naibaf7/OpenDynKVM/hardware/bom/jlcpcb_bom.csv

Comment | Designator | Footprint | LCSC Part #
22uF | C407,C408,C411,C412 | C_0805_2012Metric | C45783
18pF | C710,C711,C810,C811,C910,C911 | C_0402_1005Metric | C1549
100nF | C406,C409,C501,C502,C503,C504,C505,C506,C507,C508,C509,C510,C511,C513,C514,C515,C519,C601,C701,C702,C703,C704,C705,C706,C708,C709,C712,C801,C802,C803,C804,C805,C806,C808,C809,C812,C901,C902,C903,C904,C905,C906,C908,C909,C912,C1001,C1002,C1003,C1004,C1009,C1101,C1102,C1103,C1104,C1109,C1201,C1301,C1401,C1501,C1502,C1503,C1504,C1505,C1506,C1507,C1508,C1602 | C_0402_1005Metric | C1525
4.7uF | C516,C707,C807,C907,C1005,C1105 | C_0402_1005Metric | C23733
1uF | C101,C201,C301,C401,C402,C403,C404,C405,C413,C414,C1006,C1106,C1202,C1302,C1402,C1603 | C_0402_1005Metric | C52923
15pF | C517,C518,C1007,C1008,C1107,C1108 | C_0402_1005Metric | C1548
220uF | C415,C1203,C1303,C1403 | CP_Elec_6.3x7.7 | C46550458
10uF | C410,C512,C1601 | C_0603_1608Metric | C19702
PESD5V0S2BT | D101,D201,D301 | SOT-23 | C49338
SMF5.0A | D102,D202,D302 | D_SOD-123F | C193402
SK6812MINI-E | D1501 | LED_SK6812MINI-E_3.2x2.8mm_P1.5mm_ReverseMount | C5149201
LED KB/LED MS/LED OT/LED PC1/LED PC2 | D1502,D1503,D1504,D1505,D1506 | LED_SK6812SIDE-A_4.0x1.6mm | C5378721
USB-C | J101,J201,J301 | USB_C_Receptacle_HRO_TYPE-C-31-M-12_Edge | C165948
USB-A Keyboard/USB-A Mouse/USB-A Other | J1201,J1301,J1401 | USB_A_Molex_67643_Horizontal | C2798029
2.2uH | L401 | L_Sunlord_SWPA3015S | C43389
5.1k | R101,R102,R201,R202,R301,R302,R1604 | R_0402_1005Metric | C25905
100k | R103,R104,R203,R204,R303,R403,R405,R509,R601,R704,R705,R804,R805,R904,R905,R1201,R1205,R1301,R1305,R1401,R1405 | R_0402_1005Metric | C25741
47k | R304,R404,R409,R411 | R_0402_1005Metric | C25792
33k | R407 | R_0402_1005Metric | C25779
27R | R503,R504 | R_0402_1005Metric | C25100
10k | R402,R410,R412,R505,R507,R508,R510,R511,R512,R702,R703,R706,R707,R708,R802,R803,R806,R902,R903,R906,R1001,R1003,R1004,R1005,R1101,R1103,R1104,R1105,R1202,R1204,R1302,R1304,R1402,R1404,R1601,R1602,R1603 | R_0402_1005Metric | C25744
12k | R408,R701,R801,R901,R1002,R1102 | R_0402_1005Metric | C25752
22k | R401,R406,R1203,R1303,R1403 | R_0402_1005Metric | C25768
33R | R501,R1501 | R_0402_1005Metric | C25105
1k | R502,R506,R1605 | R_0402_1005Metric | C11702
BOOTSEL | SW501 | SW_Push_1P1T_XKB_TS-1187A | C318884
MX key | SW1501 | SW_MX_Hotswap_Kailh_1u | C49352235
USBLC6-2SC6 | U101,U201,U301,U1201,U1301,U1401 | SOT-23-6 | C7519
LM66200 | U401 | SOT-583-8 | C3235556
TPS2121 | U402 | TI_RUX0012A_VQFN-HR-12_2x2.5mm_P0.5mm | C485916
TLV62569 | U403 | SOT-23-5 | C141836
TLV73311 | U404 | SOT-23-5 | C2865431
RP2354B | U501 | QFN-80-1EP_10x10mm_P0.4mm_EP3.4x3.4mm | C39843328
USB2514B | U701,U801,U901 | QFN-36-1EP_6x6mm_P0.5mm_EP3.7x3.7mm | C16251
AT32F405CCT7 | U1001,U1101 | LQFP-48_7x7mm_P0.5mm | C47115471
TS3USB3031 | U601,U1202,U1302,U1402 | Texas_RMG0012A_WQFN-12_1.8x1.8mm_P0.4mm | C2652459
TPS2553 | U1203,U1303,U1403 | SOT-23-6 | C55266
74AHCT1G125 | U1501 | SOT-23-5 | C7484
ESP32-C3-MINI-1 | U1601 | ESP32-C3-MINI-1 | C41349510
24MHz | Y701,Y801,Y901 | Crystal_SMD_3225-4Pin_3.2x2.5mm | C70590
12MHz | Y501,Y1001,Y1101 | Crystal_SMD_3225-4Pin_3.2x2.5mm | C20625731
