naibaf7/OpenDynKVM/hardware/case/case.step

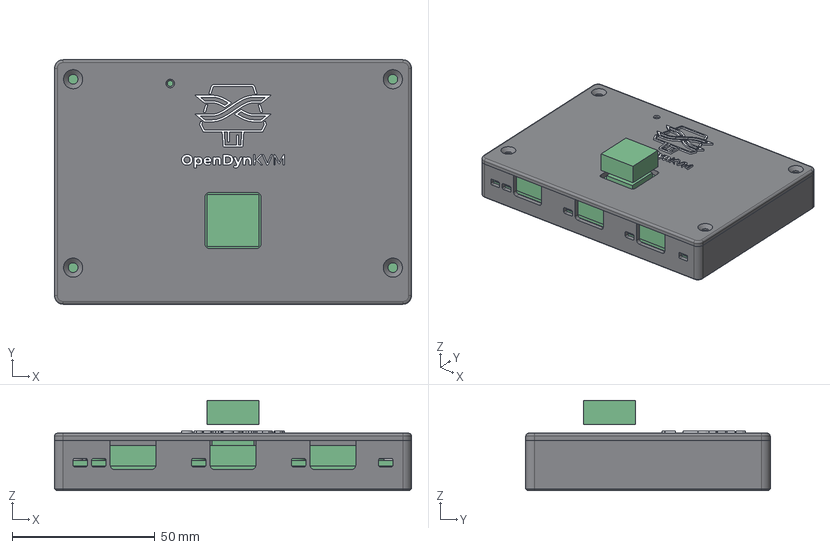
[picture p2: CAD file, 2026-11-14]
hardware/case/case.step
125.0 x 85.7 x 31.6 mm
tray
lid
logo x 17
spacer 1
spacer 2
spacer 3
spacer 4
board
part envelope x 23
