naibaf7/OpenDynKVM/hardware/case/spacers.3mf

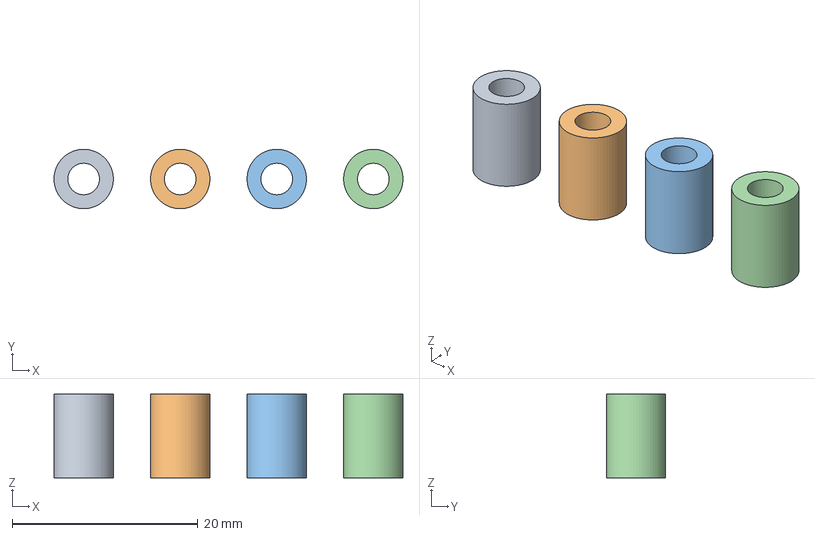
[picture p3: CAD file, 2026-11-12]
hardware/case/spacers.3mf
37.6 x 6.40 x 9.00 mm
spacer 1
spacer 2
spacer 3
spacer 4
