naibaf7/OpenDynKVM/hardware/case/lid.3mf

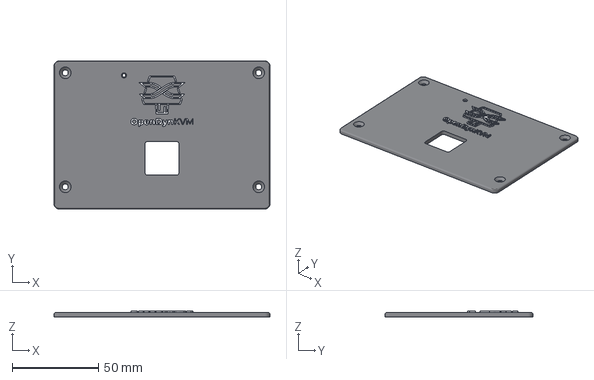
[picture p4: CAD file, 2026-11-12]
hardware/case/lid.3mf
125.0 x 85.7 x 3.30 mm
