naibaf7/OpenDynKVM/hardware/case/tray.3mf

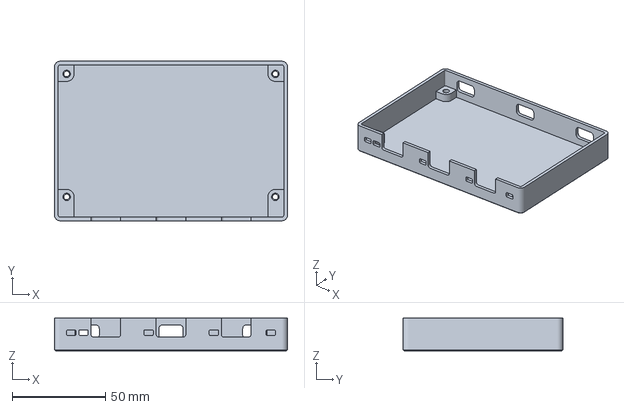
[picture p5: CAD file, 2026-11-12]
hardware/case/tray.3mf
125.0 x 85.7 x 17.6 mm
