naibaf7/OpenDynKVM/hardware/kvm_schematic.pdf

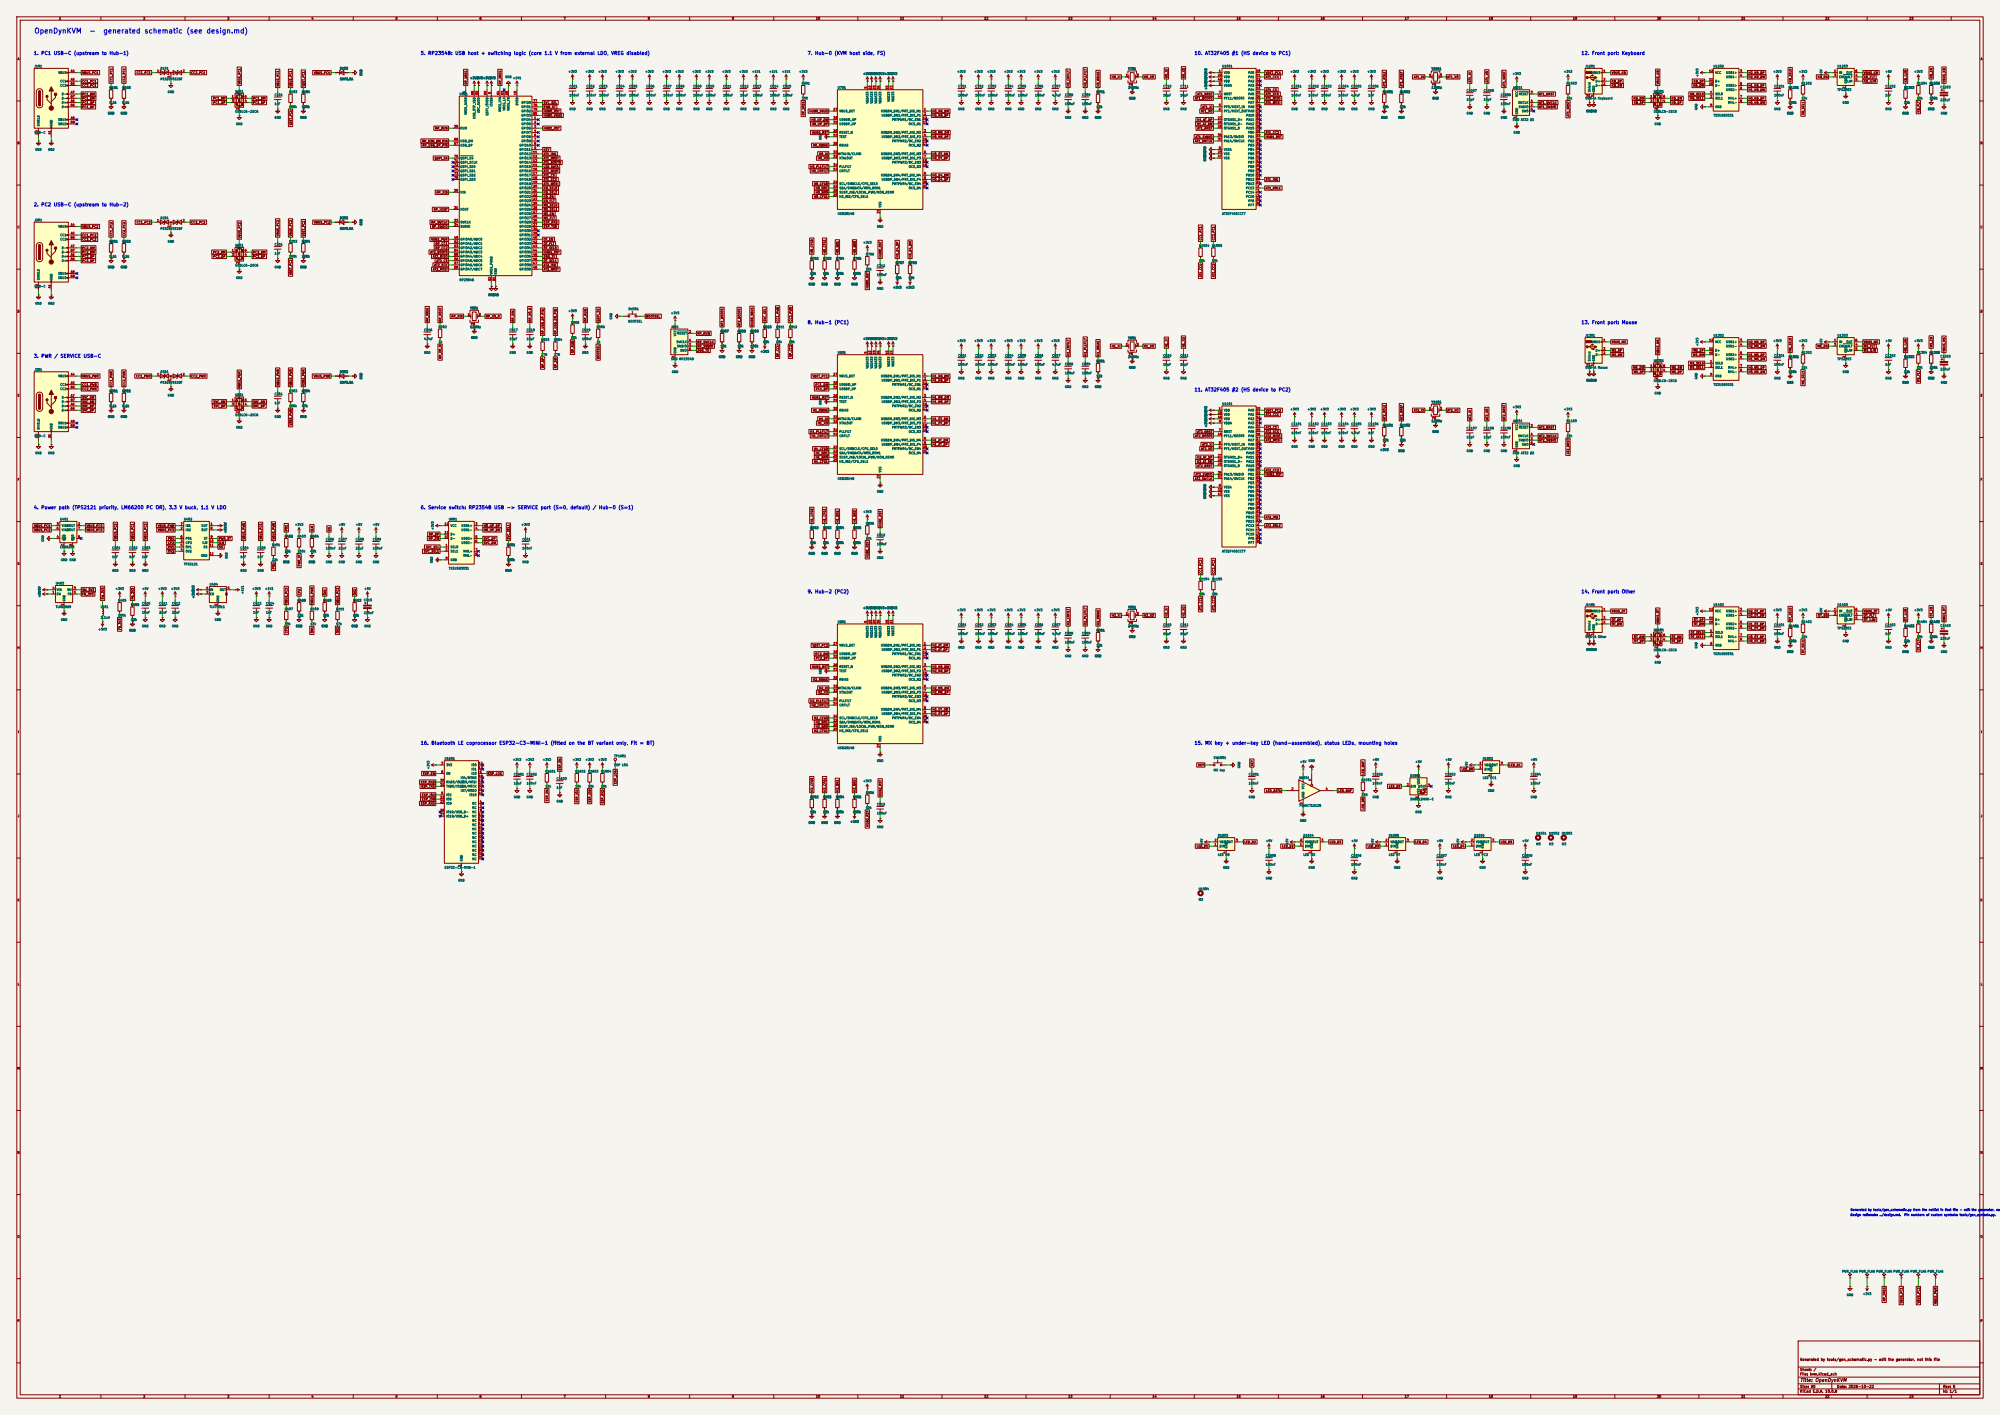
[picture p6: page 1]

OpenDynKVM - generated schematic (see design.md)

5. RP2354B: USB host + switching logic (core 1.1 V from external LDO, VREG disabled)

7. Hub-0 (KVM host side, FS)

2. PC2 USB-C (upstream to Hub-2)
J201 USB-C

4. Power path (TPS2121 priority, LM66200 PC OR), 3.3 V buck, 1.1 V LDO

6. Service switch: RP2354B USB -> SERVICE port (S=0, default) / Hub-0 (S=1)

16. Bluetooth LE coprocessor ESP32-C3-MINI-1 (fitted on the BT variant only, Fit = BT)

15. MX key + under-key LED (hand-assembled), status LEDs, mounting holes

Generated by tools/gen_schematic.py - edit the generator, not this file

Size: A0 | Rev: 5
KiCad E.D.A. 10.0.8 | Id: 1/1
