naibaf7/OpenDynKVM/hardware/kvm.kicad_pcb

## KiCad design hardware/kvm.kicad_pcb (2026-11-14)

Schematic: kvm.kicad_sch, OpenDynKVM

Parts:
C101, C201, C301, C401, C402, C403, C404, C405, C413, C414, C1006, C1106, C1202, C1302, C1402, C1603: 1uF; C_0402_1005Metric; MPN CL05A105KA5NQNC; LCSC C52923
C406, C409, C501, C502, C503, C504, C505, C506, C507, C508, C509, C510, C511, C513, C514, C515, C519, C601, C701, C702, C703, C704, C705, C706, C708, C709, C712, C801, C802, C803, C804, C805, C806, C808, C809, C812, C901, C902, C903, C904, C905, C906, C908, C909, C912, C1001, C1002, C1003, C1004, C1009, C1101, C1102, C1103, C1104, C1109, C1201, C1301, C1401, C1501, C1502, C1503, C1504, C1505, C1506, C1507, C1508, C1602: 100nF; C_0402_1005Metric; MPN CL05B104KO5NNNC; LCSC C1525
C407, C408, C411, C412: 22uF; C_0805_2012Metric; MPN CL21A226MAQNNNE; LCSC C45783
C410, C512, C1601: 10uF; C_0603_1608Metric; MPN CL10A106KP8NNNC; LCSC C19702
C415, C1203, C1303, C1403: 220uF; CP_Elec_6.3x7.7; MPN MA10V220M6X8; LCSC C46550458
C516, C707, C807, C907, C1005, C1105: 4.7uF; C_0402_1005Metric; MPN CL05A475MP5NRNC; LCSC C23733
C517, C518, C1007, C1008, C1107, C1108: 15pF; C_0402_1005Metric; MPN 0402CG150J500NT; LCSC C1548
C710, C711, C810, C811, C910, C911: 18pF; C_0402_1005Metric; MPN 0402CG180J500NT; LCSC C1549
D101, D201, D301: PESD5V0S2BT; SOT-23; MPN PESD5V0S2BT,215; LCSC C49338
D102, D202, D302: SMF5.0A; D_SOD-123F; MPN SMF5.0A; LCSC C193402
D1501: SK6812MINI-E; LED_SK6812MINI-E_3.2x2.8mm_P1.5mm_ReverseMount; MPN SK6812MINI-E; LCSC C5149201
D1502: LED PC1; LED_SK6812SIDE-A_4.0x1.6mm; MPN SK6812SIDE-A; LCSC C5378721
D1503: LED KB; LED_SK6812SIDE-A_4.0x1.6mm; MPN SK6812SIDE-A; LCSC C5378721
D1504: LED MS; LED_SK6812SIDE-A_4.0x1.6mm; MPN SK6812SIDE-A; LCSC C5378721
D1505: LED OT; LED_SK6812SIDE-A_4.0x1.6mm; MPN SK6812SIDE-A; LCSC C5378721
D1506: LED PC2; LED_SK6812SIDE-A_4.0x1.6mm; MPN SK6812SIDE-A; LCSC C5378721
H1501, H1502, H1503, H1504: M3; MountingHole_3.2mm_M3
J101, J201, J301: USB-C; USB_C_Receptacle_HRO_TYPE-C-31-M-12_Edge; MPN TYPE-C-31-M-12; LCSC C165948
J501: SWD RP2354B; Tag-Connect_TC2030-IDC-NL_2x03_P1.27mm_Vertical
J1001: SWD AT32 #1; Tag-Connect_TC2030-IDC-NL_2x03_P1.27mm_Vertical
J1101: SWD AT32 #2; Tag-Connect_TC2030-IDC-NL_2x03_P1.27mm_Vertical
J1201: USB-A Keyboard; USB_A_Molex_67643_Horizontal; MPN 676430910; LCSC C2798029
J1301: USB-A Mouse; USB_A_Molex_67643_Horizontal; MPN 676430910; LCSC C2798029
J1401: USB-A Other; USB_A_Molex_67643_Horizontal; MPN 676430910; LCSC C2798029
L401: 2.2uH; L_Sunlord_SWPA3015S; MPN SWPA3015S2R2MT; LCSC C43389
R101, R102, R201, R202, R301, R302, R1604: 5.1k; R_0402_1005Metric; MPN 0402WGF5101TCE; LCSC C25905
R103, R104, R203, R204, R303, R403, R405, R509, R601, R704, R705, R804, R805, R904, R905, R1201, R1205, R1301, R1305, R1401, R1405: 100k; R_0402_1005Metric; MPN 0402WGF1003TCE; LCSC C25741
R304, R404, R409, R411: 47k; R_0402_1005Metric; MPN 0402WGF4702TCE; LCSC C25792
R401, R406, R1203, R1303, R1403: 22k; R_0402_1005Metric; MPN 0402WGF2202TCE; LCSC C25768
R402, R410, R412, R505, R507, R508, R510, R511, R512, R702, R703, R706, R707, R708, R802, R803, R806, R902, R903, R906, R1001, R1003, R1004, R1005, R1101, R1103, R1104, R1105, R1202, R1204, R1302, R1304, R1402, R1404, R1601, R1602, R1603: 10k; R_0402_1005Metric; MPN 0402WGF1002TCE; LCSC C25744
R407: 33k; R_0402_1005Metric; MPN 0402WGF3302TCE; LCSC C25779
R408, R701, R801, R901, R1002, R1102: 12k; R_0402_1005Metric; MPN 0402WGF1202TCE; LCSC C25752
R501, R1501: 33R; R_0402_1005Metric; MPN 0402WGF330JTCE; LCSC C25105
R502, R506, R1605: 1k; R_0402_1005Metric; MPN 0402WGF1001TCE; LCSC C11702
R503, R504: 27R; R_0402_1005Metric; MPN 0402WGF270JTCE; LCSC C25100
SW501: BOOTSEL; SW_Push_1P1T_XKB_TS-1187A; MPN TS-1187A-B-A-B; LCSC C318884
SW1501: MX key; SW_MX_Hotswap_Kailh_1u; MPN CPG151101S11-2; LCSC C49352235
TP1601: ESP LOG; TestPoint_Pad_D1.0mm
U101, U201, U301, U1201, U1301, U1401: USBLC6-2SC6; SOT-23-6; MPN USBLC6-2SC6; LCSC C7519
U401: LM66200; SOT-583-8; MPN LM66200DRLR; LCSC C3235556
U402: TPS2121; TI_RUX0012A_VQFN-HR-12_2x2.5mm_P0.5mm; MPN TPS2121RUXR; LCSC C485916
U403: TLV62569; SOT-23-5; MPN TLV62569DBVR; LCSC C141836
U404: TLV73311; SOT-23-5; MPN TLV73311PDBVR; LCSC C2865431
U501: RP2354B; QFN-80-1EP_10x10mm_P0.4mm_EP3.4x3.4mm; MPN RP2354B; LCSC C39843328
U601, U1202, U1302, U1402: TS3USB3031; Texas_RMG0012A_WQFN-12_1.8x1.8mm_P0.4mm; MPN TS3USB3031RMGR; LCSC C2652459
U701, U801, U901: USB2514B; QFN-36-1EP_6x6mm_P0.5mm_EP3.7x3.7mm; MPN USB2514B-AEZC-TR; LCSC C16251
U1001, U1101: AT32F405CCT7; LQFP-48_7x7mm_P0.5mm; MPN AT32F405CCT7; LCSC C47115471
U1203, U1303, U1403: TPS2553; SOT-23-6; MPN TPS2553DBVR; LCSC C55266
U1501: 74AHCT1G125; SOT-23-5; MPN SN74AHCT1G125DBVR; LCSC C7484
U1601: ESP32-C3-MINI-1; MPN ESP32-C3-MINI-1-H4X; LCSC C41349510
Y501, Y1001, Y1101: 12MHz; Crystal_SMD_3225-4Pin_3.2x2.5mm; MPN ABM8-272-T3; LCSC C20625731
Y701, Y801, Y901: 24MHz; Crystal_SMD_3225-4Pin_3.2x2.5mm; MPN X322524MOB4SI; LCSC C70590

Connections:
+1V1: C414.1, C513.1, C514.1, C515.1, U404.5 (OUT), U501.10 (DVDD), U501.32 (DVDD), U501.51 (DVDD)
+3V3: C411.1, C412.1, C413.1, C501.1, C502.1, C503.1, C504.1, C505.1, C506.1, C507.1, C508.1, C509.1, C510.1, C511.1, C512.1, C601.1, C701.1, C702.1, C703.1, C704.1, C705.1, C706.1, C707.1, C801.1, C802.1, C803.1, C804.1, C805.1, C806.1, C807.1, C901.1, C902.1, C903.1, C904.1, C905.1, C906.1, C907.1, C1001.1, C1002.1, C1003.1, C1004.1, C1005.1, C1006.1, C1101.1, C1102.1, C1103.1, C1104.1, C1105.1, C1106.1, C1201.1, C1301.1, C1401.1, C1601.1, C1602.1, J501.1 (VCC), J1001.1 (VCC), J1101.1 (VCC), L401.2, R403.1, R405.1, R501.1, R505.1, R510.2, R706.1, R707.2, R708.2, R806.1, R905.2, R906.1, R1003.1, R1101.2, R1103.1, R1202.1, R1204.1, R1302.1, R1304.1, R1402.1, R1404.1, R1601.1, R1602.1, R1603.1, R1604.1, U404.1 (IN), U404.3 (EN), U501.5 (IOVDD), U501.15 (IOVDD), U501.24 (IOVDD), U501.29 (IOVDD), U501.41 (IOVDD), U501.50 (IOVDD), U501.59 (ADC_AVDD), U501.60 (IOVDD), U501.68 (USB_OTP_VDD), U501.69 (QSPI_IOVDD), U501.76 (IOVDD), U601.12 (VCC), U701.5 (VDDA33), U701.10 (VDDA33), U701.15 (VDD33), U701.23 (VDD33), U701.29 (VDDA33), U701.36 (VDDA33), U801.5 (VDDA33), U801.10 (VDDA33), U801.15 (VDD33), U801.23 (VDD33), U801.29 (VDDA33), U801.36 (VDDA33), U901.5 (VDDA33), U901.10 (VDDA33), U901.15 (VDD33), U901.23 (VDD33), U901.29 (VDDA33), U901.36 (VDDA33), U1001.1 (VDD), U1001.9 (VDDA), U1001.28 (VDD), U1001.48 (VDD), U1101.1 (VDD), U1101.9 (VDDA), U1101.28 (VDD), U1101.48 (VDD), U1202.12 (VCC), U1302.12 (VCC), U1402.12 (VCC), U1601.3 (3V3)
+5V: C407.1, C408.1, C409.1, C410.1, C415.1, C1202.1, C1302.1, C1402.1, C1502.1, C1503.1, C1504.1, C1505.1, C1506.1, C1507.1, C1508.1, D1501.3 (VDD), D1502.2 (VDD), D1503.2 (VDD), D1504.2 (VDD), D1505.2 (VDD), D1506.2 (VDD), U402.1 (OUT), U402.8 (OUT), U403.1 (EN), U403.4 (VIN), U1203.1 (IN), U1303.1 (IN), U1403.1 (IN), U1501.5 (VCC)
AT1_BOOT0: R507.1, U501.13 (GPIO14), U1001.44 (PF11/BOOT0)
AT1_CC1: R1004.2, U1001.11 (PA1)
AT1_CC2: R1005.2, U1001.18 (PB0)
AT1_CS: U501.17 (GPIO17), U1001.14 (PA4)
AT1_IRQ: U501.11 (GPIO12), U1001.22 (PB12)
AT1_MISO: U501.16 (GPIO16), U1001.16 (PA6)
AT1_MOSI: U501.19 (GPIO19), U1001.17 (PA7)
AT1_NRST: C1009.1, J1001.3 (~RESET), R1003.2, U501.12 (GPIO13), U1001.7 (NRST)
AT1_ROLE: R1001.1, U1001.2 (PC13)
AT1_RREF: R1002.1, U1001.25 (OTGHS1_R)
AT1_SCK: U501.18 (GPIO18), U1001.15 (PA5)
AT1_SWCLK: J1001.4 (SWCLK), U1001.37 (PA14/SWCLK)
AT1_SWDIO: J1001.2 (SWDIO), U1001.34 (PA13/SWDIO)
AT1_XI: C1007.1, U1001.5 (PF0/HEXT_IN), Y1001.1
AT1_XO: C1008.1, U1001.6 (PF1/HEXT_OUT), Y1001.3
AT2_BOOT0: R508.1, U501.54 (GPIO43/ADC3), U1101.44 (PF11/BOOT0)
AT2_CC1: R1104.2, U1101.11 (PA1)
AT2_CC2: R1105.2, U1101.18 (PB0)
AT2_CS: U501.56 (GPIO45/ADC5), U1101.14 (PA4)
AT2_IRQ: U501.47 (GPIO38), U1101.22 (PB12)
AT2_MISO: U501.55 (GPIO44/ADC4), U1101.16 (PA6)
AT2_MOSI: U501.58 (GPIO47/ADC7), U1101.17 (PA7)
AT2_NRST: C1109.1, J1101.3 (~RESET), R1103.2, U501.48 (GPIO39), U1101.7 (NRST)
AT2_ROLE: R1101.1, U1101.2 (PC13)
AT2_RREF: R1102.1, U1101.25 (OTGHS1_R)
AT2_SCK: U501.57 (GPIO46/ADC6), U1101.15 (PA5)
AT2_SWCLK: J1101.4 (SWCLK), U1101.37 (PA14/SWCLK)
AT2_SWDIO: J1101.2 (SWDIO), U1101.34 (PA13/SWDIO)
AT2_XI: C1107.1, U1101.5 (PF0/HEXT_IN), Y1101.1
AT2_XO: C1108.1, U1101.6 (PF1/HEXT_OUT), Y1101.3
BOOTSEL: R506.2, SW501.2
CC1_PC1: D101.1 (A1), J101.A5 (CC1), R101.1, R1004.1
CC1_PC2: D201.1 (A1), J201.A5 (CC1), R201.1, R1104.1
CC1_PWR: D301.1 (A1), J301.A5 (CC1), R301.1, R511.1
CC2_PC1: D101.2 (A2), J101.B5 (CC2), R102.1, R1005.1
CC2_PC2: D201.2 (A2), J201.B5 (CC2), R202.1, R1105.1
CC2_PWR: D301.2 (A2), J301.B5 (CC2), R302.1, R512.1
CP2: R407.2, R408.1, U402.3 (CP2)
DBG_TX: J501.6 (SWO), U501.45 (GPIO36)
ESP_EN: C1603.1, R1601.2, R1605.2, U1601.8 (EN)
ESP_IO2: R1602.2, U1601.5 (IO2)
ESP_IO8: R1603.2, U1601.22 (IO8)
ESP_LOG: TP1601.1, U1601.6 (IO3)
ESP_RST: R1605.1, U501.7 (GPIO9)
ESP_RXD: R1604.2, U501.36 (GPIO28), U1601.23 (IO9), U1601.30 (RXD0/IO20)
ESP_TXD: U501.37 (GPIO29), U1601.31 (TXD0/IO21)
FB_3V3: R405.2, R406.1, U403.5 (FB)
GND: C101.2, C201.2, C301.2, C401.2, C402.2, C403.2, C404.2, C405.2, C406.2, C407.2, C408.2, C409.2, C410.2, C411.2, C412.2, C413.2, C414.2, C415.2, C501.2, C502.2, C503.2, C504.2, C505.2, C506.2, C507.2, C508.2, C509.2, C510.2, C511.2, C512.2, C513.2, C514.2, C515.2, C516.2, C517.2, C518.2, C519.2, C601.2, C701.2, C702.2, C703.2, C704.2, C705.2, C706.2, C707.2, C708.2, C709.2, C710.2, C711.2, C712.2, C801.2, C802.2, C803.2, C804.2, C805.2, C806.2, C807.2, C808.2, C809.2, C810.2, C811.2, C812.2, C901.2, C902.2, C903.2, C904.2, C905.2, C906.2, C907.2, C908.2, C909.2, C910.2, C911.2, C912.2, C1001.2, C1002.2, C1003.2, C1004.2, C1005.2, C1006.2, C1007.2, C1008.2, C1009.2, C1101.2, C1102.2, C1103.2, C1104.2, C1105.2, C1106.2, C1107.2, C1108.2, C1109.2, C1201.2, C1202.2, C1203.2, C1301.2, C1302.2, C1303.2, C1401.2, C1402.2, C1403.2, C1501.2, C1502.2, C1503.2, C1504.2, C1505.2, C1506.2, C1507.2, C1508.2, C1601.2, C1602.2, C1603.2, D101.3 (common), D102.2 (A), D201.3 (common), D202.2 (A), D301.3 (common), D302.2 (A), D1501.1 (VSS), D1502.4 (GND), D1503.4 (GND), D1504.4 (GND), D1505.4 (GND), D1506.4 (GND), J101.A1 (GND), J101.A12 (GND), J101.B1 (GND), J101.B12 (GND), J101.SH (SHIELD), J201.A1 (GND), J201.A12 (GND), J201.B1 (GND), J201.B12 (GND), J201.SH (SHIELD), J301.A1 (GND), J301.A12 (GND), J301.B1 (GND), J301.B12 (GND), J301.SH (SHIELD), J501.5 (GND), J1001.5 (GND), J1101.5 (GND), J1201.4 (GND), J1201.SH (Shield), J1301.4 (GND), J1301.SH (Shield), J1401.4 (GND), J1401.SH (Shield), R101.2, R102.2, R104.2, R201.2, R202.2, R204.2, R301.2, R302.2, R304.2, R402.2, R404.2, R406.2, R408.2, R410.2, R412.2, R507.2, R508.2, R509.2, R601.2, R701.2, R702.2, R703.2, R704.2, R705.2, R801.2, R802.2, R803.2, R804.2, R805.2, R901.2, R902.2, R903.2, R904.2, R1001.2, R1002.2, R1102.2, R1201.2, R1203.2, R1205.2, R1301.2, R1303.2, R1305.2, R1401.2, R1403.2, R1405.2, SW501.1, SW1501.2, U101.2 (GND), U201.2 (GND), U301.2 (GND), U401.1 (GND), U401.4 (~ON), U401.5 (GND), U402.12 (GND), U403.2 (GND), U404.2 (GND), U501.62 (VREG_PGND), U501.65 (VREG_FB), U501.81 (GND), U601.9 (GND), U701.11 (TEST), U701.37 (VSS), U801.11 (TEST), U801.37 (VSS), U901.11 (TEST), U901.37 (VSS), U1001.8 (VSSA), U1001.23 (VSS), U1001.47 (VSS), U1101.8 (VSSA), U1101.23 (VSS), U1101.47 (VSS), U1201.2 (GND), U1202.9 (GND), U1203.2 (GND), U1301.2 (GND), U1302.9 (GND), U1303.2 (GND), U1401.2 (GND), U1402.9 (GND), U1403.2 (GND), U1501.1, U1501.3 (GND), U1601.1 (GND), U1601.2 (GND), U1601.11 (GND), U1601.14 (GND), U1601.36 (GND), U1601.37 (GND), U1601.38 (GND), U1601.39 (GND), U1601.40 (GND), U1601.41 (GND), U1601.42 (GND), U1601.43 (GND), U1601.44 (GND), U1601.45 (GND), U1601.46 (GND), U1601.47 (GND), U1601.48 (GND), U1601.49 (GND), U1601.50 (GND), U1601.51 (GND), U1601.52 (GND), U1601.53 (GND), Y501.2 (G), Y501.4 (G), Y701.2 (G), Y701.4 (G), Y801.2 (G), Y801.4 (G), Y901.2 (G), Y901.4 (G), Y1001.2 (G), Y1001.4 (G), Y1101.2 (G), Y1101.4 (G)
H0_CFG0: R702.1, U701.24 (SCL/SMBCLK/CFG_SEL0)
H0_CFG1: R703.1, U701.25 (HS_IND/CFG_SEL1)
H0_CRFILT: C708.1, U701.14 (CRFILT)
H0_D4_DM: R708.1, U701.8 (USBDM_DN4/PRT_DIS_M4)
H0_D4_DP: R707.1, U701.9 (USBDP_DN4/PRT_DIS_P4)
H0_KB_DM: U701.1 (USBDM_DN1/PRT_DIS_M1), U1202.8 (MHL-)
H0_KB_DP: U701.2 (USBDP_DN1/PRT_DIS_P1), U1202.7 (MHL+)
H0_MS_DM: U701.3 (USBDM_DN2/PRT_DIS_M2), U1302.8 (MHL-)
H0_MS_DP: U701.4 (USBDP_DN2/PRT_DIS_P2), U1302.7 (MHL+)
H0_NR0: R705.1, U701.28 (SUSP_IND/LOCAL_PWR/NON_REM0)
H0_NR1: R704.1, U701.22 (SDA/SMBDATA/NON_REM1)
H0_OT_DM: U701.6 (USBDM_DN3/PRT_DIS_M3), U1402.8 (MHL-)
H0_OT_DP: U701.7 (USBDP_DN3/PRT_DIS_P3), U1402.7 (MHL+)
H0_PLLFILT: C709.1, U701.34 (PLLFILT)
H0_RBIAS: R701.1, U701.35 (RBIAS)
H0_UP_DM: U601.4 (USB1-), U701.30 (USBDM_UP)
H0_UP_DP: U601.3 (USB1+), U701.31 (USBDP_UP)
H0_XI: C710.1, U701.33 (XTALIN/CLKIN), Y701.1
H0_XO: C711.1, U701.32 (XTALOUT), Y701.3
H1_AT_DM: U801.8 (USBDM_DN4/PRT_DIS_M4), U1001.26 (OTGHS1_D-)
H1_AT_DP: U801.9 (USBDP_DN4/PRT_DIS_P4), U1001.27 (OTGHS1_D+)
H1_CFG0: R802.1, U801.24 (SCL/SMBCLK/CFG_SEL0)
H1_CFG1: R803.1, U801.25 (HS_IND/CFG_SEL1)
H1_CRFILT: C808.1, U801.14 (CRFILT)
H1_KB_DM: U801.1 (USBDM_DN1/PRT_DIS_M1), U1202.6 (USB2-)
H1_KB_DP: U801.2 (USBDP_DN1/PRT_DIS_P1), U1202.5 (USB2+)
H1_MS_DM: U801.3 (USBDM_DN2/PRT_DIS_M2), U1302.6 (USB2-)
H1_MS_DP: U801.4 (USBDP_DN2/PRT_DIS_P2), U1302.5 (USB2+)
H1_NR0: R805.1, U801.28 (SUSP_IND/LOCAL_PWR/NON_REM0)
H1_NR1: R804.1, U801.22 (SDA/SMBDATA/NON_REM1)
H1_OT_DM: U801.6 (USBDM_DN3/PRT_DIS_M3), U1402.6 (USB2-)
H1_OT_DP: U801.7 (USBDP_DN3/PRT_DIS_P3), U1402.5 (USB2+)
H1_PLLFILT: C809.1, U801.34 (PLLFILT)
H1_RBIAS: R801.1, U801.35 (RBIAS)
H1_XI: C810.1, U801.33 (XTALIN/CLKIN), Y801.1
H1_XO: C811.1, U801.32 (XTALOUT), Y801.3
H2_AT_DM: U901.1 (USBDM_DN1/PRT_DIS_M1), U1101.26 (OTGHS1_D-)
H2_AT_DP: U901.2 (USBDP_DN1/PRT_DIS_P1), U1101.27 (OTGHS1_D+)
H2_CFG0: R902.1, U901.24 (SCL/SMBCLK/CFG_SEL0)
H2_CFG1: R903.1, U901.25 (HS_IND/CFG_SEL1)
H2_CRFILT: C908.1, U901.14 (CRFILT)
H2_KB_DM: U901.3 (USBDM_DN2/PRT_DIS_M2), U1202.4 (USB1-)
H2_KB_DP: U901.4 (USBDP_DN2/PRT_DIS_P2), U1202.3 (USB1+)
H2_MS_DM: U901.6 (USBDM_DN3/PRT_DIS_M3), U1302.4 (USB1-)
H2_MS_DP: U901.7 (USBDP_DN3/PRT_DIS_P3), U1302.3 (USB1+)
H2_NR0: R905.1, U901.28 (SUSP_IND/LOCAL_PWR/NON_REM0)
H2_NR1: R904.1, U901.22 (SDA/SMBDATA/NON_REM1)
H2_OT_DM: U901.8 (USBDM_DN4/PRT_DIS_M4), U1402.4 (USB1-)
H2_OT_DP: U901.9 (USBDP_DN4/PRT_DIS_P4), U1402.3 (USB1+)
H2_PLLFILT: C909.1, U901.34 (PLLFILT)
H2_RBIAS: R901.1, U901.35 (RBIAS)
H2_XI: C910.1, U901.33 (XTALIN/CLKIN), Y901.1
H2_XO: C911.1, U901.32 (XTALOUT), Y901.3
HUB0_RST: C712.1, R706.2, U501.79 (GPIO2), U701.26 (RESET_N)
HUB0_VBUS: R509.1, U501.80 (GPIO3), U701.27 (VBUS_DET)
HUB1_RST: C812.1, R806.2, U501.3 (GPIO6), U801.26 (RESET_N), U1001.19 (PB1)
HUB2_RST: C912.1, R906.2, U501.44 (GPIO35), U901.26 (RESET_N), U1101.19 (PB1)
ILM: R404.1, U402.10 (ILM)
KB_DM: J1201.2 (D-), U1201.1 (I/O1), U1201.6 (I/O1), U1202.10 (D-)
KB_DP: J1201.3 (D+), U1201.3 (I/O2), U1201.4 (I/O2), U1202.11 (D+)
KB_EN: R1205.1, U501.22 (GPIO22), U1203.3 (EN)
KB_FLT: R1204.2, U501.23 (GPIO23), U1203.4 (~FAULT)
KB_ILIM: R1203.1, U1203.5 (ILIM)
KB_SEL0: R1201.1, U501.20 (GPIO20), U1202.1 (SEL0)
KB_SEL1: R1202.2, U501.21 (GPIO21), U1202.2 (SEL1)
KEY: C1501.1, SW1501.1, U501.9 (GPIO11)
LED_BUF: R1501.1, U1501.4
LED_D0: D1502.1 (DIN), R1501.2
LED_D1: D1502.3 (DOUT), D1503.1 (DIN)
LED_D2: D1503.3 (DOUT), D1504.1 (DIN)
LED_D3: D1504.3 (DOUT), D1505.1 (DIN)
LED_D4: D1505.3 (DOUT), D1506.1 (DIN)
LED_D5: D1501.2 (DIN), D1506.3 (DOUT)
LED_DATA: U501.14 (GPIO15), U1501.2
MS_DM: J1301.2 (D-), U1301.1 (I/O1), U1301.6 (I/O1), U1302.10 (D-)
MS_DP: J1301.3 (D+), U1301.3 (I/O2), U1301.4 (I/O2), U1302.11 (D+)
MS_EN: R1305.1, U501.27 (GPIO26), U1303.3 (EN)
MS_FLT: R1304.2, U501.28 (GPIO27), U1303.4 (~FAULT)
MS_ILIM: R1303.1, U1303.5 (ILIM)
MS_SEL0: R1301.1, U501.25 (GPIO24), U1302.1 (SEL0)
MS_SEL1: R1302.2, U501.26 (GPIO25), U1302.2 (SEL1)
OT_DM: J1401.2 (D-), U1401.1 (I/O1), U1401.6 (I/O1), U1402.10 (D-)
OT_DP: J1401.3 (D+), U1401.3 (I/O2), U1401.4 (I/O2), U1402.11 (D+)
OT_EN: R1405.1, U501.40 (GPIO32), U1403.3 (EN)
OT_FLT: R1404.2, U501.42 (GPIO33), U1403.4 (~FAULT)
OT_ILIM: R1403.1, U1403.5 (ILIM)
OT_SEL0: R1401.1, U501.43 (GPIO34), U1402.1 (SEL0)
OT_SEL1: R1402.2, U501.46 (GPIO37), U1402.2 (SEL1)
OV1: R409.2, R410.1, U402.5 (OV1)
OV2: R411.2, R412.1, U402.4 (OV2)
PC1_DM: J101.A7 (D-), J101.B7 (D-), U101.1 (I/O1), U101.6 (I/O1), U801.30 (USBDM_UP)
PC1_DP: J101.A6 (D+), J101.B6 (D+), U101.3 (I/O2), U101.4 (I/O2), U801.31 (USBDP_UP)
PC2_DM: J201.A7 (D-), J201.B7 (D-), U201.1 (I/O1), U201.6 (I/O1), U901.30 (USBDM_UP)
PC2_DP: J201.A6 (D+), J201.B6 (D+), U201.3 (I/O2), U201.4 (I/O2), U901.31 (USBDP_UP)
PR1: R401.2, R402.1, U402.6 (PR1)
PWR_ST: R403.2, U402.9 (ST), U501.78 (GPIO1)
QSPI_SS: R506.1, U501.75 (~QSPI_SS)
RP_CC1: R511.2, U501.52 (GPIO41/ADC1)
RP_CC2: R512.2, U501.53 (GPIO42/ADC2)
RP_DM: R504.2, U601.10 (D-)
RP_DP: R503.2, U601.11 (D+)
RP_RUN: C519.1, J501.3 (~RESET), R505.2, U501.35 (RUN)
RP_SWCLK: J501.4 (SWCLK), U501.33 (SWCLK)
RP_SWDIO: J501.2 (SWDIO), U501.34 (SWDIO)
RP_USB_DM_PIN: R504.1, U501.66 (USB_DM)
RP_USB_DP_PIN: R503.1, U501.67 (USB_DP)
RP_VREG: C516.1, R501.2, U501.61 (VREG_AVDD), U501.64 (VREG_VIN)
RP_XIN: C517.1, U501.30 (XIN), Y501.1
RP_XOUT: R502.1, U501.31 (XOUT)
RP_XO_R: C518.1, R502.2, Y501.3
SS: C406.1, U402.11 (SS)
SVC_DM: J301.A7 (D-), J301.B7 (D-), U301.1 (I/O1), U301.6 (I/O1), U601.6 (USB2-)
SVC_DP: J301.A6 (D+), J301.B6 (D+), U301.3 (I/O2), U301.4 (I/O2), U601.5 (USB2+)
SVC_SEL: R510.1, U501.77 (GPIO0), U601.1 (SEL0)
SVC_SEL1: R601.1, U601.2 (SEL1)
SW_3V3: L401.1, U403.3 (SW)
VBUS_KB: C1203.1, J1201.1 (VBUS), U1201.5 (VBUS), U1203.6 (OUT)
VBUS_MS: C1303.1, J1301.1 (VBUS), U1301.5 (VBUS), U1303.6 (OUT)
VBUS_OT: C1403.1, J1401.1 (VBUS), U1401.5 (VBUS), U1403.6 (OUT)
VBUS_PC1: C101.1, C402.1, D102.1 (K), J101.A4 (VBUS), J101.A9 (VBUS), J101.B4 (VBUS), J101.B9 (VBUS), R103.1, U101.5 (VBUS), U401.3 (VIN1)
VBUS_PC2: C201.1, C403.1, D202.1 (K), J201.A4 (VBUS), J201.A9 (VBUS), J201.B4 (VBUS), J201.B9 (VBUS), R203.1, U201.5 (VBUS), U401.6 (VIN2)
VBUS_PCS: C401.1, C405.1, R407.1, R411.1, U401.2 (VOUT), U401.7 (VOUT), U402.2 (IN2)
VBUS_PWR: C301.1, C404.1, D302.1 (K), J301.A4 (VBUS), J301.A9 (VBUS), J301.B4 (VBUS), J301.B9 (VBUS), R303.1, R401.1, R409.1, U301.5 (VBUS), U402.7 (IN1)
VDET_PC1: R103.2, R104.1, U801.27 (VBUS_DET), U1001.10 (PA0)
VDET_PC2: R203.2, R204.1, U901.27 (VBUS_DET), U1101.10 (PA0)
VSNS_PWR: R303.2, R304.1, U501.49 (GPIO40/ADC0)

Notes on the sheet:
OpenDynKVM - generated schematic (see design.md)
1. PC1 USB-C (upstream to Hub-1)
2. PC2 USB-C (upstream to Hub-2)
3. PWR / SERVICE USB-C
4. Power path (TPS2121 priority, LM66200 PC OR), 3.3 V buck, 1.1 V LDO
5. RP2354B: USB host + switching logic (core 1.1 V from external LDO, VREG disabled)
6. Service switch: RP2354B USB -> SERVICE port (S=0, default) / Hub-0 (S=1)
7. Hub-0 (KVM host side, FS)
8. Hub-1 (PC1)
9. Hub-2 (PC2)
10. AT32F405 #1 (HS device to PC1)
11. AT32F405 #2 (HS device to PC2)
12. Front port: Keyboard
13. Front port: Mouse
14. Front port: Other
15. MX key + under-key LED (hand-assembled), status LEDs, mounting holes
16. Bluetooth LE coprocessor ESP32-C3-MINI-1 (fitted on the BT variant only, Fit = BT)
Generated by tools/gen_schematic.py from the netlist in that file - edit the generator, not this sheet.
Design rationale: ../design.md. Pin numbers of custom symbols: tools/gen_symbols.py.

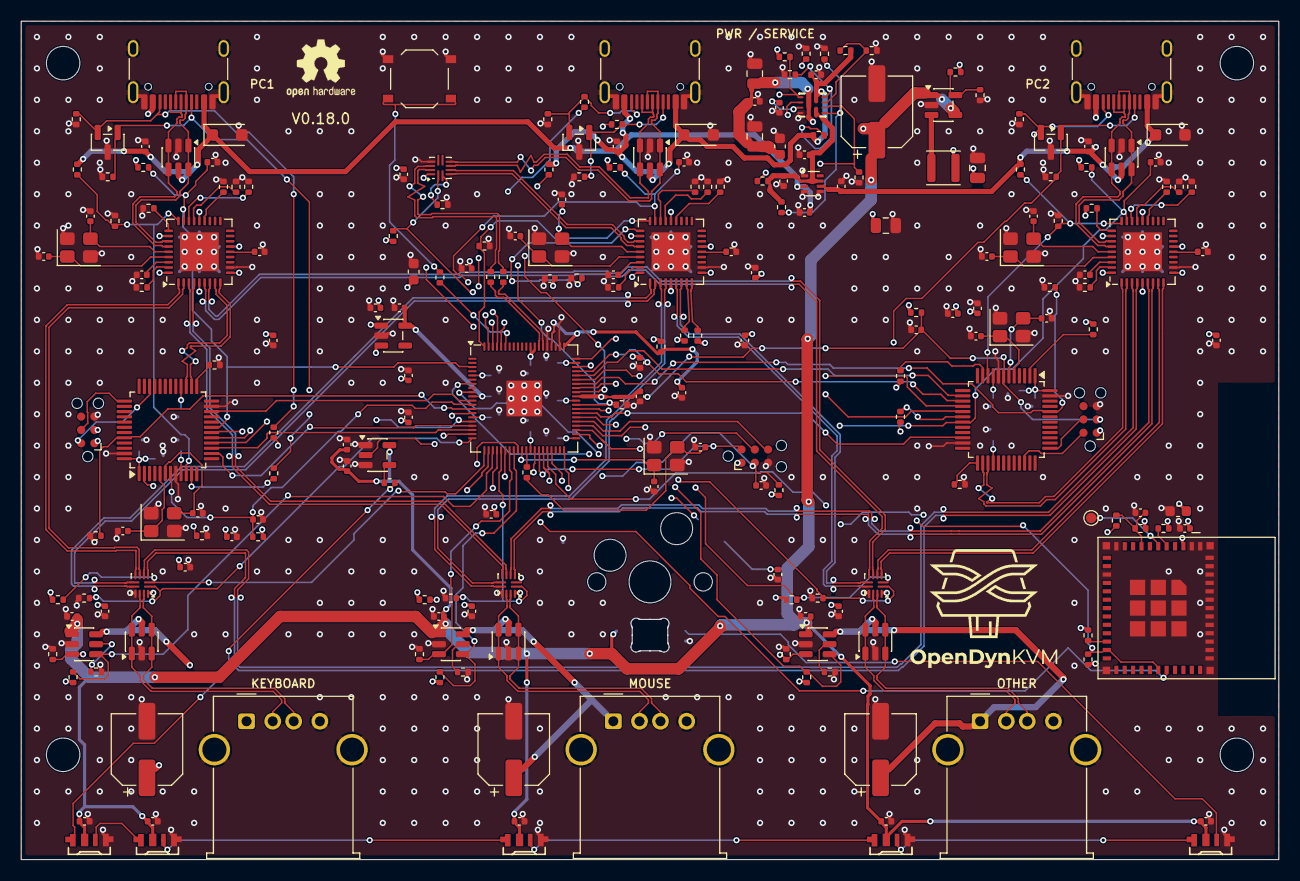
[picture p7: board kvm.kicad_pcb from above]

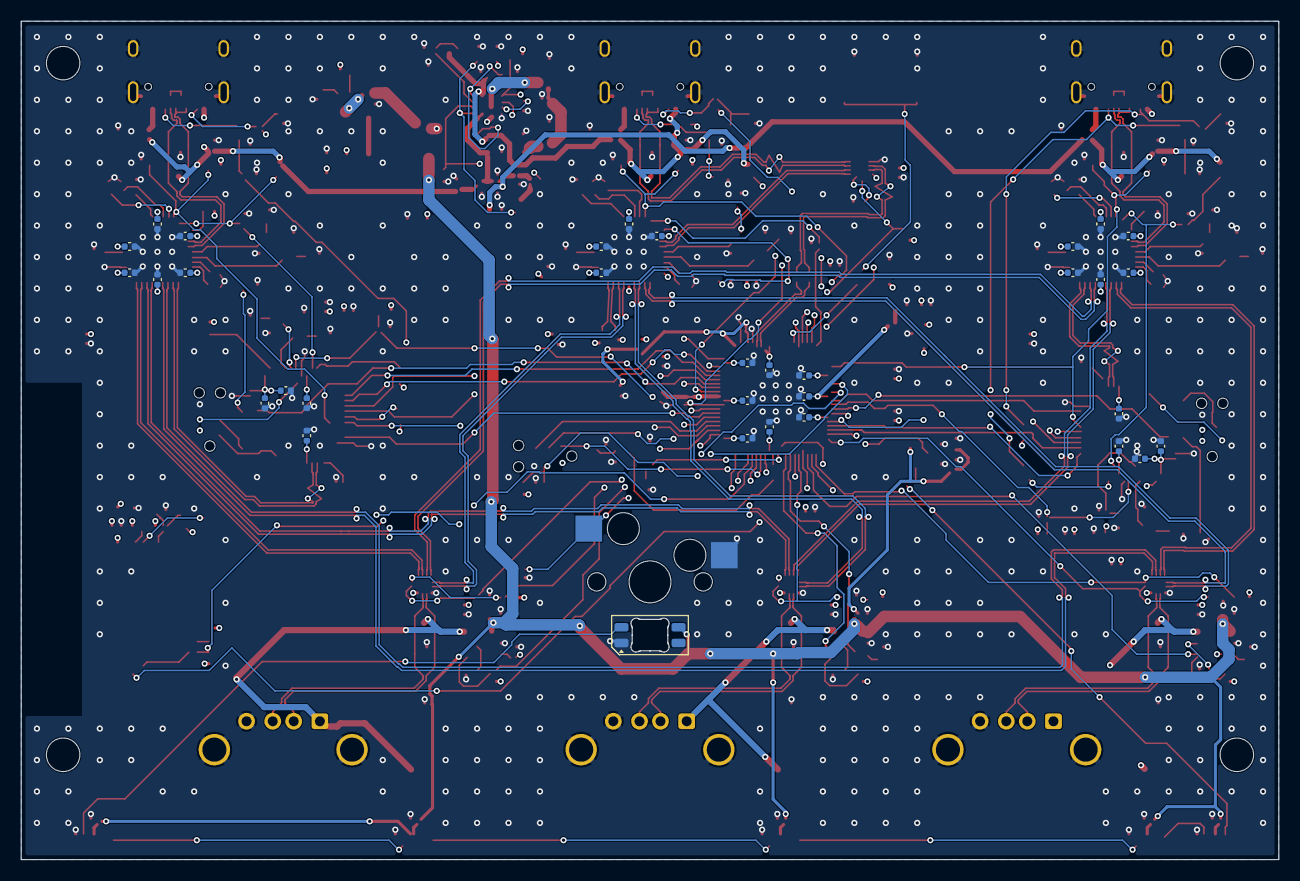
[picture p8: board kvm.kicad_pcb from below]

Board: 4 copper layers, 120.0 x 80.0 mm, 262 parts (33 on the bottom side), 177 nets.

Other parts of the board:
LOGO1: OpenDynKVM_Logo_14mm_SilkScreen
LOGO2: OSHW-Logo2_7.3x6mm_SilkScreen
