naibaf7/OpenDynKVM/software/odkvmctl/src/bin/opendyn-kvm/worker.rs

//! Background thread that owns the connection: runs UI commands, refreshes the snapshot, collects events, and
//! reconnects when the KVM goes away.

use std::collections::VecDeque;
use std::path::PathBuf;
use std::sync::mpsc::{Receiver, RecvTimeoutError, Sender, TryRecvError, channel};
use std::sync::{Arc, Mutex};
use std::thread::JoinHandle;
use std::time::{Duration, Instant};

use kvm_core::hotkey::format_spec;
use kvm_proto::ctrl::{
    ConfigValue, ErrorCode, Event, FwState, HopState, Hotkey, LearnEnd, Port, PortMode, RebootTarget, Target, diag,
};
use odkvmctl::bootsel::{self, BootDevice};
use odkvmctl::client::Snapshot;
use odkvmctl::ddc::KvmState;
use odkvmctl::{Client, Error, firmware, fl, image, names};

pub enum UiCmd {
    Switch(Target),
    PortMode(Port, PortMode),
    Redetect(Port),
    Config(ConfigValue),
    Save,
    FactoryReset,
    Identify,
    Update(PathBuf),
    /// Give the AT32F405s up to 5 more programming attempts (the KVM restarts).
    RetryAt32,
    /// Give the Bluetooth module up to 5 more programming attempts (the KVM restarts).
    RetryBt,
    /// Start (true) or stop learning a hotkey from the KVM's keyboard.
    Learn(bool),
    /// Fetch the diagnostics (`Shared::diag`).
    Diagnose,
    /// Open (true) or close Bluetooth pairing.
    BtPair(bool),
    /// Forget the Bluetooth host in a slot.
    BtForget(u8),
    /// The passkey a pairing host shows.
    BtPasskey(u32),
}

#[derive(Default)]
pub struct Shared {
    pub snap: Option<Snapshot>,
    /// Description of the connected KVM.
    pub device: Option<String>,
    pub error: Option<String>,
    pub events: VecDeque<String>,
    pub update: Option<(FwState, usize, usize)>,
    pub update_result: Option<Result<(), String>>,
    /// How learning a hotkey ended, or why it couldn't start.
    pub learn: Option<Result<(LearnEnd, Hotkey), String>>,
    /// With the simulator: its keyboard, which the window's keys play while a hotkey is learned.
    pub sim_keyboard: Option<Sender<[u8; 8]>>,
    /// The last diagnostics and when they came (Err: why there are none).
    pub diag: Option<(Instant, Result<Vec<diag::Item>, String>)>,
    /// RP2350 boot ROMs on USB (a KVM in its bootloader, on the PWR/SERVICE port), looked for while no KVM answers on
    /// a PC port ([`spawn_boot_scan`]).
    pub boot: Vec<BootDevice>,
    /// Installing onto one of them: its location, the 512-byte blocks done and their total; and how the last ended.
    pub boot_install: Option<(String, usize, usize)>,
    pub boot_result: Option<(String, Result<(), String>)>,
    /// The firmware file dialog is open; the file it returned, until the window takes it.
    pub picking: bool,
    pub picked: Option<PathBuf>,
}

pub type Wake = Arc<dyn Fn() + Send + Sync>;

const REFRESH: Duration = Duration::from_millis(1000);
/// How often the boot ROMs on USB are looked for while no KVM answers.
const BOOT_SCAN: Duration = Duration::from_secs(1);
const RECONNECT: Duration = Duration::from_secs(2);
/// Screen hop: this computer's cursor goes to the KVM once it has rested this long (software.md §4.14).
const CURSOR_REST: Duration = Duration::from_millis(250);

/// This computer's cursor for screen hop: reported to the KVM once each time it comes to rest, so the KVM takes over
/// where something else (a touchpad, a program, the system's own acceleration) put it. Only where the system tells
/// programs the cursor position (Windows).
#[derive(Default)]
struct CursorSync {
    seen: Option<[i32; 2]>,
    since: Option<Instant>,
    sent: bool,
}

impl CursorSync {
    fn poll(&mut self, c: &mut Client, hop: bool) {
        if !hop {
            return;
        }
        let Some(p) = odkvmctl::screens::cursor() else { return };
        if self.seen != Some(p) {
            *self = CursorSync { seen: Some(p), since: Some(Instant::now()), sent: false };
            return;
        }
        if !self.sent && self.since.is_some_and(|t| t.elapsed() >= CURSOR_REST) {
            self.sent = true;
            let _ = c.pointer_at(p.map(|v| v.clamp(i16::MIN as i32, i16::MAX as i32) as i16));
        }
    }
}

/// An event as the Overview's list shows it; None for the Bluetooth events, which [`bt_changes`] tells with names.
fn describe(e: &Event) -> Option<String> {
    Some(match e {
        Event::Switched(pc, src) => {
            fl!("ev-switched", target = pc.name().to_uppercase(), source = names::switch_source(*src))
        }
        Event::PortChanged(p) => fl!("ev-port-changed", port = names::port_title(*p)),
        Event::Fault(kind, Some(p)) => {
            fl!("ev-fault-port", port = names::port_title(*p), fault = names::fault_kind(*kind))
        }
        Event::Fault(kind, None) => fl!("ev-fault", fault = names::fault_kind(*kind)),
        Event::ConfigChanged(k) => fl!("ev-setting-changed", name = names::config_name(*k)),
        Event::HotkeyLearned(LearnEnd::Learned, h) => fl!("ev-hotkey-learned", hotkey = format_spec(h).to_string()),
        Event::HotkeyLearned(end, _) => fl!("ev-hotkey-not-learned", why = names::learn_end(*end)),
        Event::BtActive(_) | Event::BtChanged(_) => return None,
    })
}

/// What changed for the Bluetooth hosts between two snapshots, in words and with the hosts' names: the KVM's events
/// only say which slot changed.
fn bt_changes(old: &Snapshot, new: &Snapshot) -> Vec<String> {
    let mut out = Vec::new();
    if !new.has_bluetooth() {
        return out;
    }
    let (o, n) = (&old.status, &new.status);
    if o.bt_pairing == 0 && n.bt_pairing != 0 {
        out.push(fl!("ev-pairing-open"));
    }
    if o.bt_passkey == 0 && n.bt_passkey != 0 {
        out.push(fl!("ev-passkey-wanted"));
    }
    let mut paired = false;
    for h in &new.bt {
        let before = old.bt.iter().find(|b| b.slot == h.slot);
        let was = |f: fn(&odkvmctl::client::BtHostView) -> bool| before.is_some_and(f);
        if h.bonded() && !was(|b| b.bonded()) {
            out.push(fl!("ev-paired", host = h.name.as_str(), slot = h.slot));
            paired = true;
        } else if !h.bonded() && was(|b| b.bonded()) {
            let name = before.map_or(h.name.as_str(), |b| b.name.as_str());
            out.push(fl!("ev-forgot", host = name));
        } else if h.bonded() && h.ready() && !was(|b| b.ready()) {
            out.push(fl!("ev-host-connected", host = h.name.as_str()));
        } else if h.bonded() && !h.connected() && was(|b| b.connected()) {
            out.push(fl!("ev-host-disconnected", host = h.name.as_str()));
        }
    }
    if o.bt_pairing != 0 && n.bt_pairing == 0 && !paired {
        out.push(fl!("ev-pairing-closed"));
    }
    if n.bt_active != 0 && n.bt_active != o.bt_active {
        let name = new.bt.iter().find(|h| h.slot == n.bt_active).map_or_else(|| fl!("a-host"), |h| h.name.clone());
        out.push(fl!("ev-switched-host", host = name));
    }
    out
}

/// Sets the monitors' inputs when the KVM's active PC or profile changes (`odkvmctl::ddc`), on its own thread: DDC/CI
/// takes 50 ms or more per monitor, and the worker must keep polling the KVM. The first state it hears of is only noted:
/// the monitors are assumed to show it already.
fn follower(shared: Arc<Mutex<Shared>>, wake: Wake) -> Sender<KvmState> {
    let (tx, rx) = channel::<KvmState>();
    std::thread::spawn(move || {
        let mut last = None;
        while let Ok(mut to) = rx.recv() {
            // Several changes in a row: only the last one counts.
            while let Ok(s) = rx.try_recv() {
                to = s;
            }
            if let Some(from) = last.as_ref().filter(|from| **from != to) {
                let local = odkvmctl::local::load();
                for e in odkvmctl::ddc::follow(from, &to, &local.displays) {
                    shared.lock().unwrap().events.push_front(fl!("ev-monitor-not-switched", error = e));
                    wake();
                }
            }
            last = Some(to);
        }
    });
    tx
}

/// The monitors' view of a snapshot: active PC, the Bluetooth host with the input (by address), profile.
fn kvm_state(s: &Snapshot) -> KvmState {
    let bt = s.bt.iter().find(|h| h.slot == s.status.bt_active && s.status.bt_active != 0).map(|h| h.address());
    KvmState { pc: s.status.active.index(), bt, profile: s.profiles().map_or(0, |p| p.0 as usize) }
}

/// Passes the KVM's active PC, Bluetooth host and profile on to the follower when they change.
fn tell(follow: &Option<Sender<KvmState>>, last: &mut Option<KvmState>, state: KvmState) {
    if last.as_ref() != Some(&state) {
        *last = Some(state.clone());
        if let Some(f) = follow {
            let _ = f.send(state);
        }
    }
}

/// Lost the device (as opposed to the device refusing a request).
fn is_disconnect(e: &Error) -> bool {
    matches!(e, Error::Transport(_) | Error::Timeout)
}
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
