naibaf7/OpenDynKVM/(commit log)

2026-11-12 OpenDynKVM: hardware 0.17.0, firmware and host software 0.1.10
    An open-source USB KVM switch for two PCs with persistent emulation: each PC keeps an emulated keyboard, mouse and
    other device, so a switch takes under a millisecond and nothing re-enumerates.
    - Hardware 0.17.0 (KiCad 10, generated by hardware/tools/), designed; the first boards, 0.12.0, are up.
    - Firmware 0.1.10 for the RP2354B, both AT32F405s and the optional ESP32-C3 Bluetooth module.
    - odkvmctl and opendyn-kvm 0.1.10 for Windows and Linux, in English, French, German, Norwegian Bokmål and
    Simplified Chinese.
    This is the first public commit; the design work before it is not part of the public history.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
    [hand_assembly.csv, jlcpcb_bom.csv, jlcpcb_bom_nobt.csv, kvm.kicad_pcb, kvm.kicad_sch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]
2026-11-12 Screen hop with a monitor cabled to both PCs, a 3D-printable case, uv
    Firmware and host software 0.1.11, protocol 8:
    - Every screen a PC has goes in the arrangement. A monitor cabled to both PCs is switched off for hop on the PC
    that doesn't show it and laid on the other PC's screen: the pointer passes to the other PC there, and its own PC
    still counts it, so the absolute pointer lands right on its other screens (KDE spreads it over the whole desktop).
    The flags, off for hop and a fixed place on the PC, are bits 7 and 6 of the screen slot's PC byte.
    - Each PC's units: physical pixels (Windows, X11) or logical ones (Wayland). KDE's screens are read with
    kscreen-doctor, since XWayland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
    [case.step, lid.3mf, spacers.3mf, tray.3mf]
2026-11-12 3D models and renders of the board; the Bluetooth module on the top side
    Hardware 0.17.0 (not ordered yet):
    - Every part has a 3D model. KiCad's library (kicad-packages3d) covers most; tools/fetch_3d.py takes the EasyEDA
    model of the eight LCSC parts it has none for (QFN-80, WQFN-12, HRO USB-C, TS-1187A, TPS2121, SK6812SIDE-A,
    ESP32-C3-MINI-1, the hot-swap socket), placed by EasyEDA's own data and the JLC correction (checked against 31
    parts that have both), and draws the MX switch and a keycap to the case's numbers. The files stay a local cache
    (3dmodels/); their placement is tools/models_3d.json, which gen_pcb.py puts on the footprints (--models on a
    routed board).
    - tools/render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
    [case.step, kvm.kicad_pcb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]
2026-11-12 Firmware and host software 0.1.12: passthrough speed, an empty port after a re-probe
    From the first 0.12.0 board (2026-11-12):
    - A port in passthrough reports the speed its device runs at on the PC's hub: high for a high-speed device (it
    answers GET_DESCRIPTOR(DEVICE_QUALIFIER) when probed at Hub-0's full speed), unless that hub's own link to the
    PC is full speed. Until 0.1.11 it showed Hub-0's full speed.
    - A re-probe (re-detect, or back from passthrough) that sees no device on Hub-0 within 2 s (REPROBE_MS) leaves the
    port empty: a device unplugged in passthrough left it probing, blinking yellow, for good.
2026-11-14 Firmware and host software 0.1.17: screen hop arrangements, wireless hosts in screen hop, the module on a front port
    Protocol 9 (firmware and host software 0.1.13 to 0.1.17; 0.1.12 is the last release on main):
    - Screen hop with four named arrangements kept on the KVM at once (config keys 0x00B0-0x00CF, names 0x00D0-0x00D3).
    Each profile uses one or none (ProfileArrangement, 0x00A8-0x00AB), so switching profiles switches the arrangement
    without writing flash. Arrangements are store items of their own; a config from 0.1.12 or older brings its one
    arrangement as arrangement 0.
    - Wireless hosts take part in screen hop: a screen can belong to a host slot, and each host has its own mapping,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
2026-11-14 Firmware and host software 0.1.19, hardware 0.18.0: the module's reset line, pairing that holds, a module watchdog
    Bluetooth module firmware (ESP32-C3):
    - Pairing: a connection holds its slot from the moment it is let in. A new host pairs only into a slot that no bond
    and no connection holds. Before, a second unknown device let in while one paired got the same free slot: a
    connected phone showed as "not connected", or its pairing broke off after the passkey.
    - Pairing again: a bonded host that forgot the KVM pairs anew into its own slot while pairing is open. Every
    connection is bondable from the start, because trouble-host answers the pairing request before the firmware
    hears of it.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
    [case.step, jlcpcb_bom.csv, jlcpcb_bom_nobt.csv, kvm.kicad_pcb, kvm.kicad_sch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]
